lucas-traumen/CAN-cluster/hardware/board-stm32-v1/actuator-v1/actuator-v1.kicad_pcb

## KiCad design hardware/board-stm32-v1/actuator-v1/actuator-v1.kicad_pcb (2026-10-07)

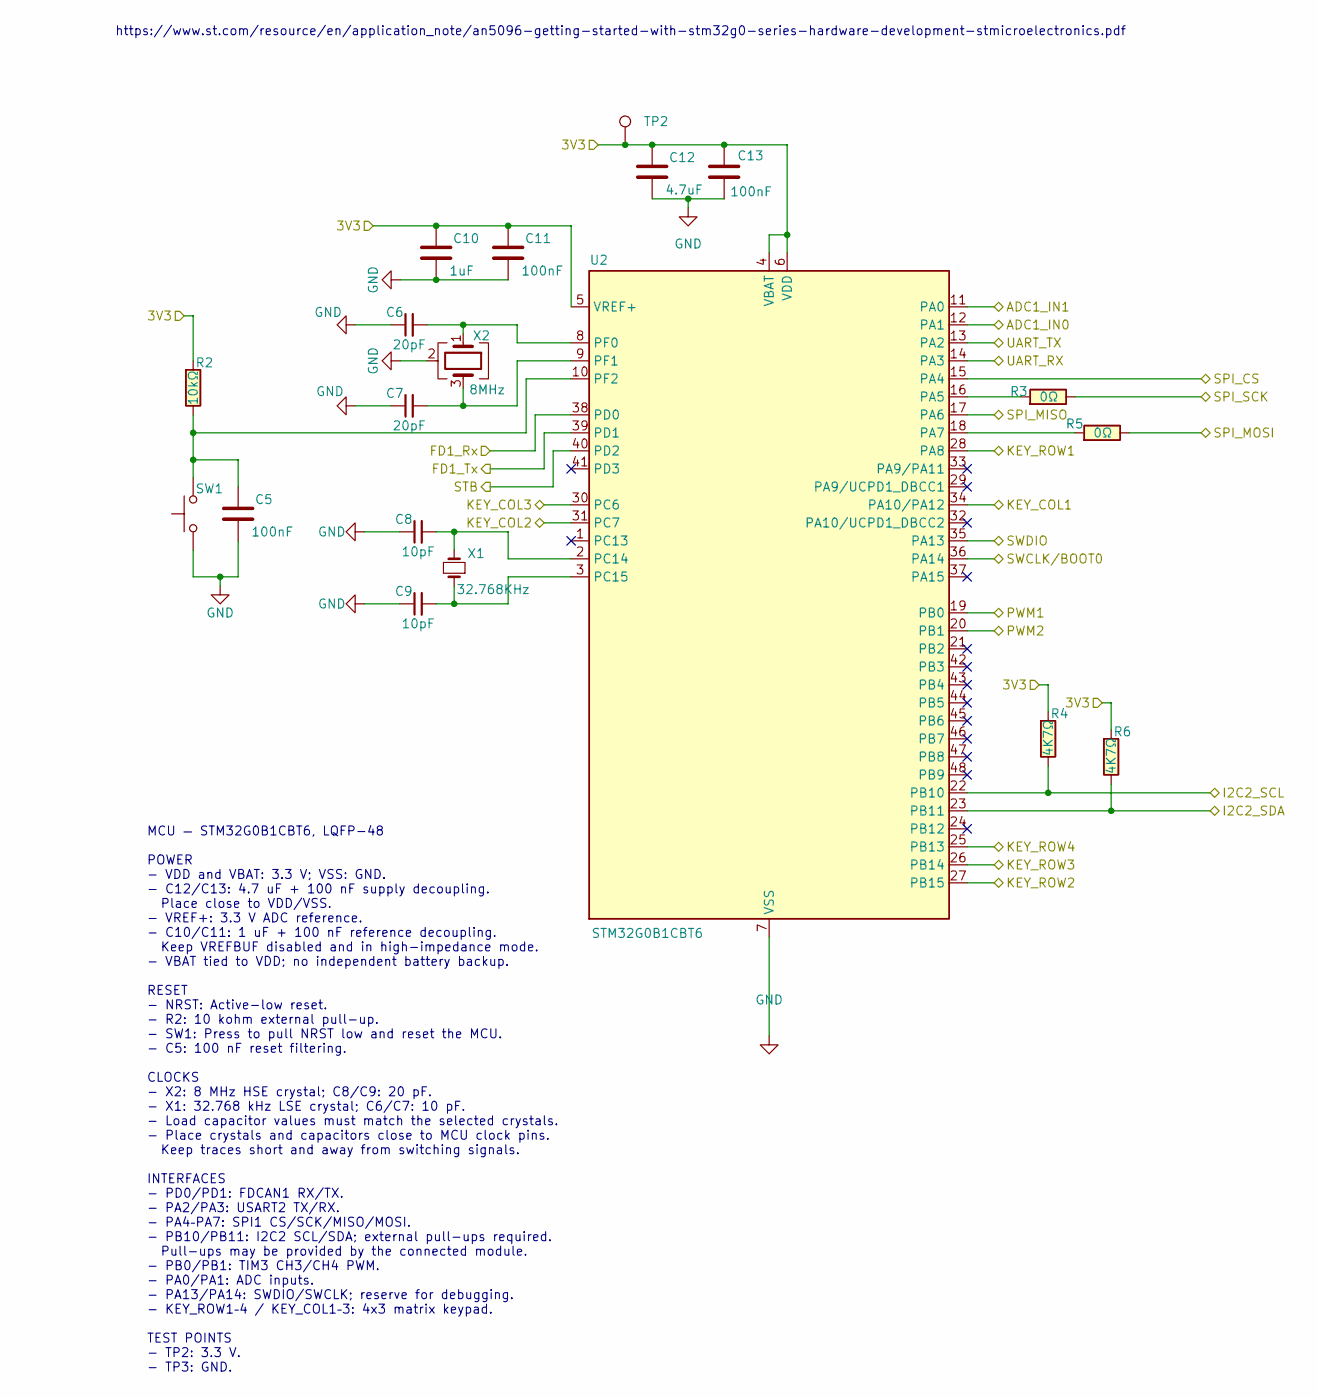
[picture p1: schematic MCU-STM32G0B1RBT6.kicad_sch]

Parts:
C5, C11, C13: 100nF; C_0603
C6, C7: 20pF; C_0603
C8, C9: 10pF; C_0603
C10: 1uF; C_0603
C12: 4.7uF; C_0603
R2: 10kΩ; R_0603
R3, R5: 0Ω; R_0603
R4, R6: 4K7Ω; R_0603
SW1: SW_Push; SW_SPST_CK_RS282G05A3
TP2: TestPoint; TestPoint_Pad_D1.5mm
U2: STM32G0B1CBT6; LQFP-48_7x7mm_P0.5mm
X1: 32.768KHz; Crystal_SMD_3215-2Pin_3.2x1.5mm
X2: 8MHz; Crystal_SMD_3225-4Pin_3.2x2.5mm

Connections:
/MCU-STM32G0B1CBT6/ADC1_IN0: U2.12 (PA1); also elsewhere on the board
/MCU-STM32G0B1CBT6/ADC1_IN1: U2.11 (PA0); also elsewhere on the board
/MCU-STM32G0B1CBT6/FD1_Rx: U2.38 (PD0); also elsewhere on the board
/MCU-STM32G0B1CBT6/FD1_Tx: U2.39 (PD1); also elsewhere on the board
/MCU-STM32G0B1CBT6/I2C2_SCL: R4.2, U2.22 (PB10); also elsewhere on the board
/MCU-STM32G0B1CBT6/I2C2_SDA: R6.2, U2.23 (PB11); also elsewhere on the board
/MCU-STM32G0B1CBT6/KEY_COL1: U2.34 (PA10/PA12); also elsewhere on the board
/MCU-STM32G0B1CBT6/KEY_COL2: U2.31 (PC7); also elsewhere on the board
/MCU-STM32G0B1CBT6/KEY_COL3: U2.30 (PC6); also elsewhere on the board
/MCU-STM32G0B1CBT6/KEY_ROW1: U2.28 (PA8); also elsewhere on the board
/MCU-STM32G0B1CBT6/KEY_ROW2: U2.27 (PB15); also elsewhere on the board
/MCU-STM32G0B1CBT6/KEY_ROW3: U2.26 (PB14); also elsewhere on the board
/MCU-STM32G0B1CBT6/KEY_ROW4: U2.25 (PB13); also elsewhere on the board
/MCU-STM32G0B1CBT6/PWM1: U2.19 (PB0); also elsewhere on the board
/MCU-STM32G0B1CBT6/PWM2: U2.20 (PB1); also elsewhere on the board
/MCU-STM32G0B1CBT6/SPI_CS: U2.15 (PA4); also elsewhere on the board
/MCU-STM32G0B1CBT6/SPI_MISO: U2.17 (PA6); also elsewhere on the board
/MCU-STM32G0B1CBT6/SPI_MOSI: R5.2; also elsewhere on the board
/MCU-STM32G0B1CBT6/SPI_SCK: R3.2; also elsewhere on the board
/MCU-STM32G0B1CBT6/STB: U2.40 (PD2); also elsewhere on the board
/MCU-STM32G0B1CBT6/SWCLK/BOOT0: U2.36 (PA14); also elsewhere on the board
/MCU-STM32G0B1CBT6/SWDIO: U2.35 (PA13); also elsewhere on the board
/MCU-STM32G0B1CBT6/UART_RX: U2.14 (PA3); also elsewhere on the board
/MCU-STM32G0B1CBT6/UART_TX: U2.13 (PA2); also elsewhere on the board
/Power5-3V3/+3V3: C10.1, C11.1, C12.1, C13.1, R2.1, R4.1, R6.1, TP2.1 (1_1), U2.4 (VBAT), U2.5 (VREF+), U2.6 (VDD); also elsewhere on the board
GND: C5.2, C6.1, C7.1, C8.1, C9.1, C10.2, C11.2, C12.2, C13.2, SW1.1, U2.7 (VSS), X2.2 (G), X2.4 (G); also elsewhere on the board
unnamed: R3.1, U2.16 (PA5)
unnamed: R5.1, U2.18 (PA7)
unnamed: C8.2, U2.2 (PC14), X1.2
unnamed: C9.2, U2.3 (PC15), X1.1
unnamed: C6.2, U2.8 (PF0), X2.1
unnamed: C7.2, U2.9 (PF1), X2.3
unnamed: C5.1, R2.2, SW1.2, U2.10 (PF2)

Notes on the sheet:
MCU — STM32G0B1CBT6, LQFP-48 POWER - VDD and VBAT: 3.3 V; VSS: GND. - C12/C13: 4.7 uF + 100 nF supply decoupling. Place close to VDD/VSS. - VREF+: 3.3 V ADC reference. - C10/C11: 1 uF + 100 nF reference decoupling. Keep VREFBUF disabled and in high-impedance mode. - VBAT tied to VDD; no independent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
https://www.st.com/resource/en/application_note/an5096-getting-started-with-stm32g0-series-hardware-development-stmicroelectronics.pdf

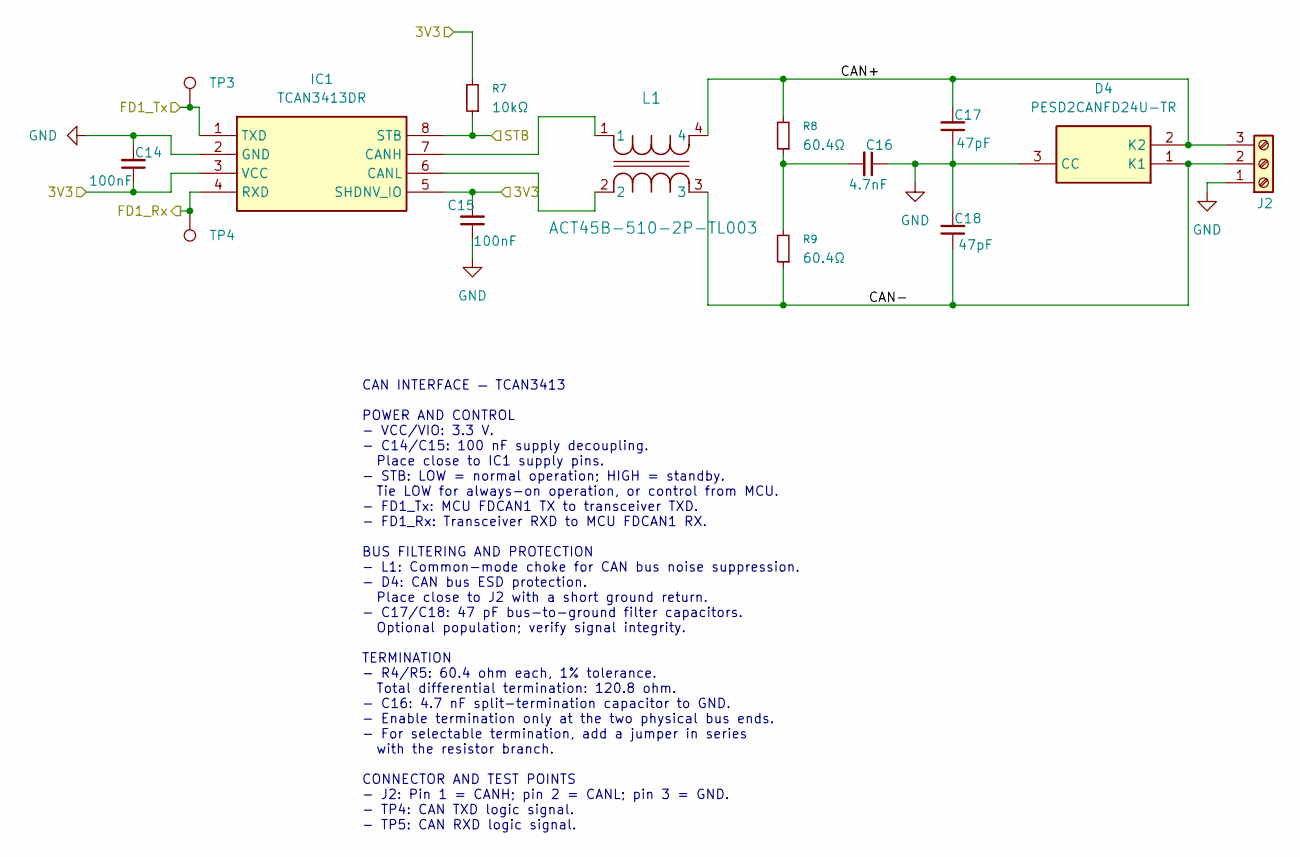
[picture p2: schematic TCAN3413.kicad_sch]

Parts:
C14, C15: 100nF; C_0603
C16: 4.7nF; C_0603
C17, C18: 47pF; C_0603
D4: PESD2CANFD24U-TR; SOT95P230X110-3N; Manufacturer_Part_Number PESD2CANFD24U-TR; Mouser Part Number 771-PESD2CANFD24U-TR
IC1: TCAN3413DR; SOIC127P600X175-8N; Manufacturer_Part_Number TCAN3413DR; Mouser Part Number 595-TCAN3413DR
J2: Screw_Terminal_01x03; PhoenixContact_MSTBA_2,5_3-G-5,08_1x03_P5.08mm_Horizontal
L1: ACT45B-510-2P-TL003; IND_ACT45R_TDK
R7: 10kΩ; R_0603
R8, R9: 60.4Ω; R_0805_2012Metric
TP3, TP4: TestPoint; TestPoint_Pad_D1.0mm

Connections:
/MCU-STM32G0B1CBT6/FD1_Rx: IC1.4 (RXD), TP4.1 (1_1); also elsewhere on the board
/MCU-STM32G0B1CBT6/FD1_Tx: IC1.1 (TXD), TP3.1 (1_1); also elsewhere on the board
/MCU-STM32G0B1CBT6/STB: IC1.8 (STB), R7.1; also elsewhere on the board
/Power5-3V3/+3V3: C14.1, C15.2, IC1.3 (VCC), IC1.5 (SHDNV_IO), R7.2; also elsewhere on the board
/TCAN3413/CAN+: C17.2, D4.2 (K2), J2.3, L1.4, R8.2
/TCAN3413/CAN-: C18.1, D4.1 (K1), J2.2, L1.3, R9.1
GND: C14.2, C15.1, C16.1, C17.1, C18.2, D4.3 (CC), IC1.2 (GND), J2.1; also elsewhere on the board
unnamed: C16.2, R8.1, R9.2
unnamed: IC1.7 (CANH), L1.1
unnamed: IC1.6 (CANL), L1.2

Notes on the sheet:
CAN INTERFACE — TCAN3413 POWER AND CONTROL - VCC/VIO: 3.3 V. - C14/C15: 100 nF supply decoupling. Place close to IC1 supply pins. - STB: LOW = normal operation; HIGH = standby. Tie LOW for always-on operation, or control from MCU. - FD1_Tx: MCU FDCAN1 TX to transceiver TXD. - FD1_Rx: Transceiver RX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

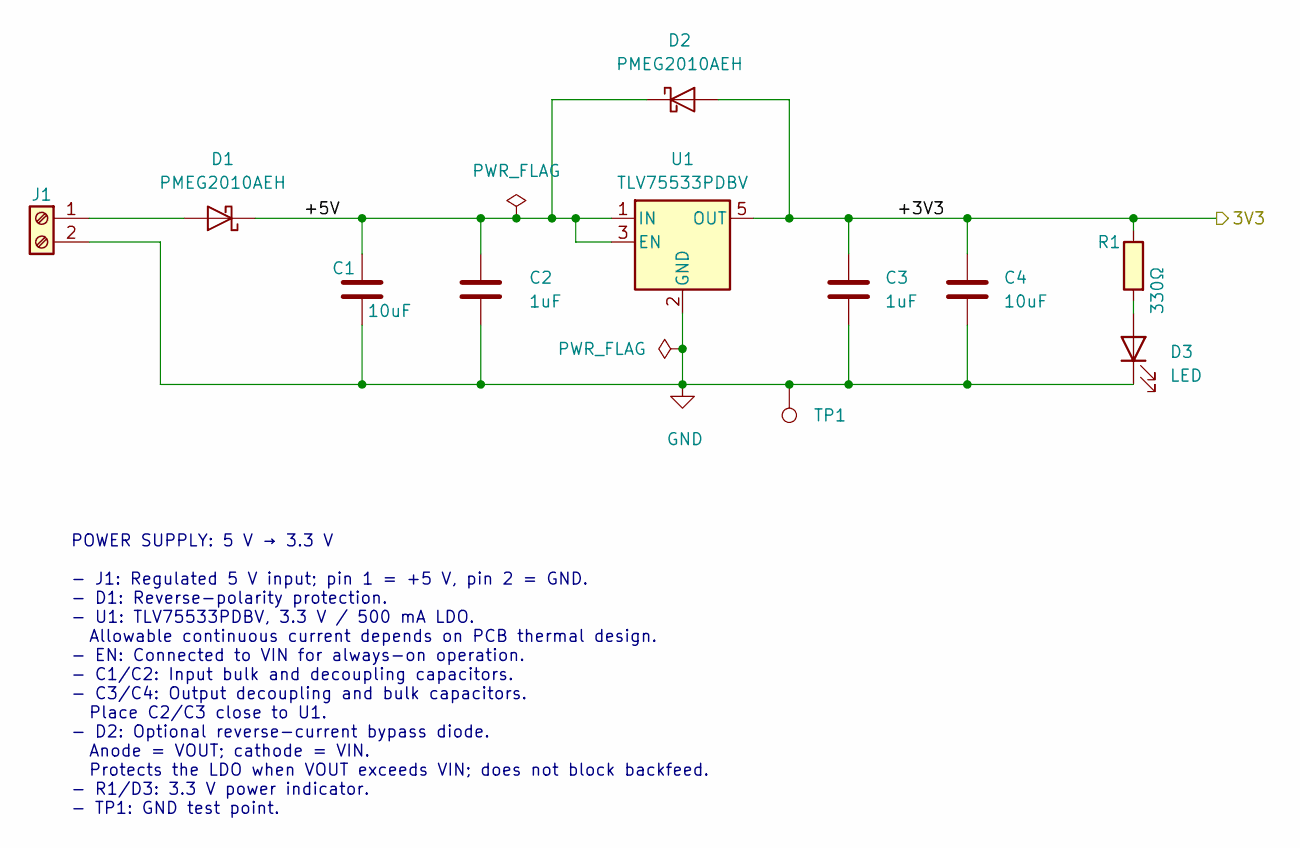
[picture p3: schematic Power5-3V3.kicad_sch]

Parts:
C1, C4: 10uF; C_0805_2012Metric_Pad1.18x1.45mm_HandSolder
C2, C3: 1uF; C_0603
D1, D2: PMEG2010AEH; D_SOD-123F
D3: LED; LED_0603_1608Metric
J1: Screw_Terminal_01x02; PhoenixContact_MSTBA_2,5_2-G-5,08_1x02_P5.08mm_Horizontal
R1: 330Ω; R_0603
TP1: TestPoint; TestPoint_Pad_D1.5mm
U1: TLV75533PDBV; SOT-23-5

Connections:
/Power5-3V3/+3V3: C3.1, C4.1, D2.2 (A), R1.2, U1.5 (OUT); also elsewhere on the board
/Power5-3V3/+5V: C1.1, C2.1, D1.1 (K), D2.1 (K), U1.1 (IN), U1.3 (EN)
GND: C1.2, C2.2, C3.2, C4.2, D3.1 (K), J1.2, TP1.1 (1_1), U1.2 (GND); also elsewhere on the board
unnamed: D1.2 (A), J1.1
unnamed: D3.2 (A), R1.1

Notes on the sheet:
POWER SUPPLY: 5 V → 3.3 V - J1: Regulated 5 V input; pin 1 = +5 V, pin 2 = GND. - D1: Reverse-polarity protection. - U1: TLV75533PDBV, 3.3 V / 500 mA LDO. Allowable continuous current depends on PCB thermal design. - EN: Connected to VIN for always-on operation. - C1/C2: Input bulk and decoupling c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

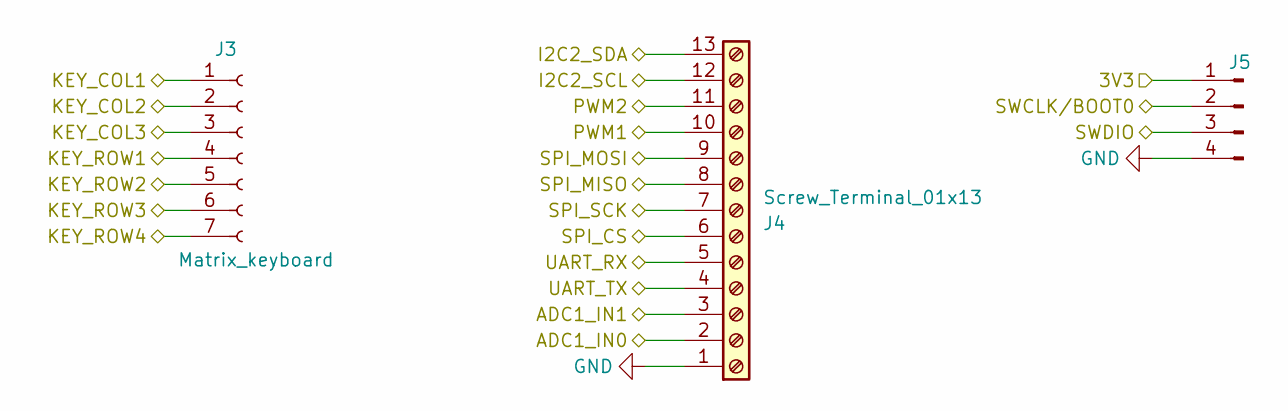
[picture p4: schematic Terminal.kicad_sch]

Parts:
J3: Matrix_keyboard; JST_XH_B7B-XH-A_1x07_P2.50mm_Vertical
J4: Screw_Terminal_01x13; PhoenixContact_MSTBA_2,5_13-G-5,08_1x13_P5.08mm_Horizontal
J5: Conn_01x04_Pin; PinHeader_1x04_P2.54mm_Vertical

Connections:
/MCU-STM32G0B1CBT6/ADC1_IN0: J4.2; also elsewhere on the board
/MCU-STM32G0B1CBT6/ADC1_IN1: J4.3; also elsewhere on the board
/MCU-STM32G0B1CBT6/I2C2_SCL: J4.12; also elsewhere on the board
/MCU-STM32G0B1CBT6/I2C2_SDA: J4.13; also elsewhere on the board
/MCU-STM32G0B1CBT6/KEY_COL1: J3.1; also elsewhere on the board
/MCU-STM32G0B1CBT6/KEY_COL2: J3.2; also elsewhere on the board
/MCU-STM32G0B1CBT6/KEY_COL3: J3.3; also elsewhere on the board
/MCU-STM32G0B1CBT6/KEY_ROW1: J3.4; also elsewhere on the board
/MCU-STM32G0B1CBT6/KEY_ROW2: J3.5; also elsewhere on the board
/MCU-STM32G0B1CBT6/KEY_ROW3: J3.6; also elsewhere on the board
/MCU-STM32G0B1CBT6/KEY_ROW4: J3.7; also elsewhere on the board
/MCU-STM32G0B1CBT6/PWM1: J4.10; also elsewhere on the board
/MCU-STM32G0B1CBT6/PWM2: J4.11; also elsewhere on the board
/MCU-STM32G0B1CBT6/SPI_CS: J4.6; also elsewhere on the board
/MCU-STM32G0B1CBT6/SPI_MISO: J4.8; also elsewhere on the board
/MCU-STM32G0B1CBT6/SPI_MOSI: J4.9; also elsewhere on the board
/MCU-STM32G0B1CBT6/SPI_SCK: J4.7; also elsewhere on the board
/MCU-STM32G0B1CBT6/SWCLK/BOOT0: J5.2; also elsewhere on the board
/MCU-STM32G0B1CBT6/SWDIO: J5.3; also elsewhere on the board
/MCU-STM32G0B1CBT6/UART_RX: J4.5; also elsewhere on the board
/MCU-STM32G0B1CBT6/UART_TX: J4.4; also elsewhere on the board
/Power5-3V3/+3V3: J5.1; also elsewhere on the board
GND: J4.1, J5.4; also elsewhere on the board

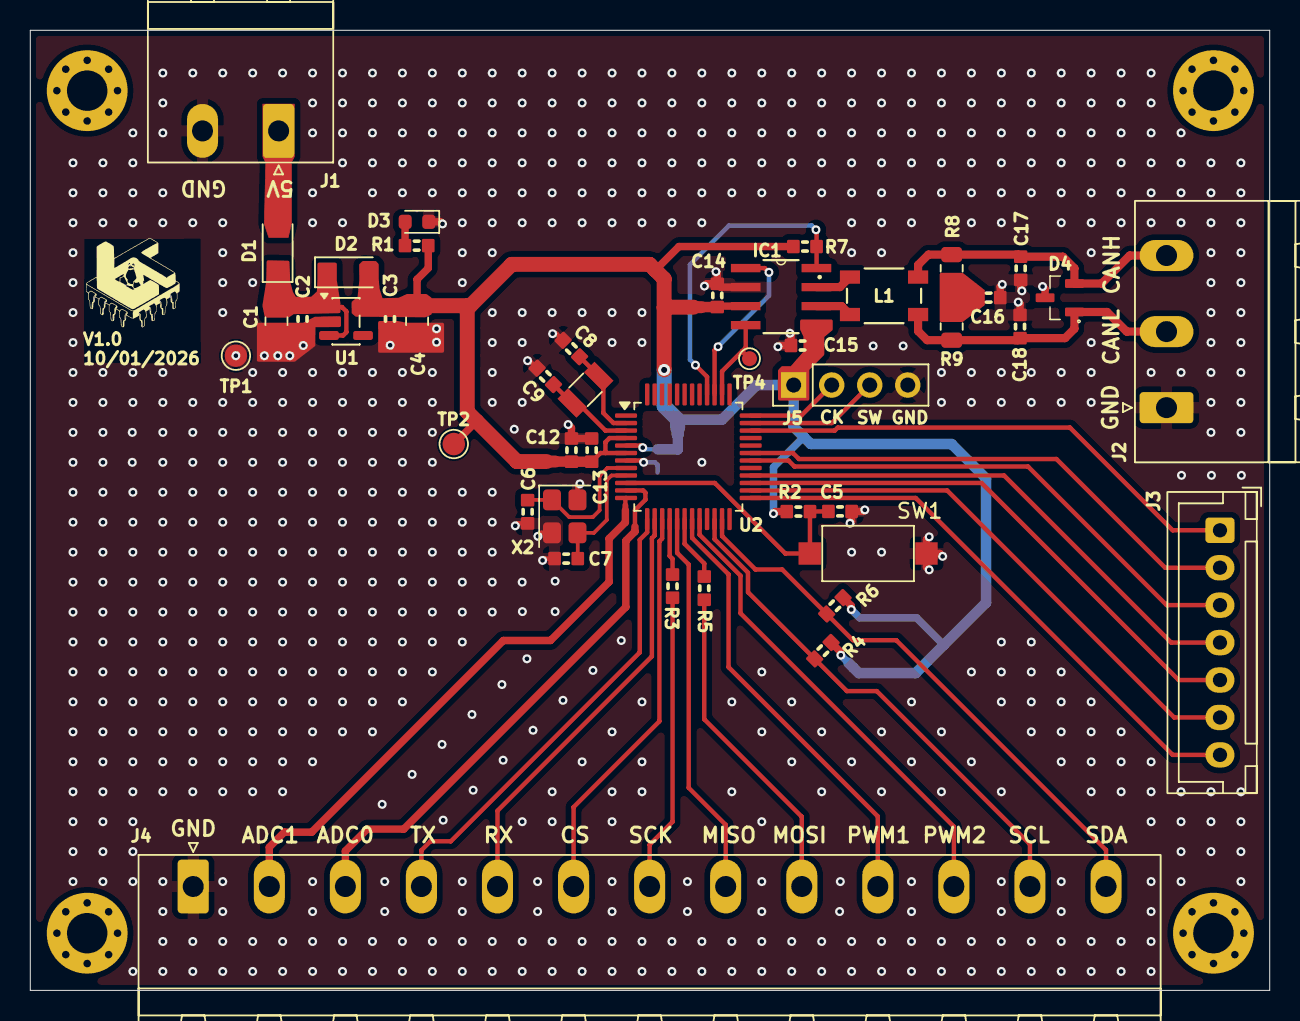
[picture p5: board actuator-v1.kicad_pcb from above]

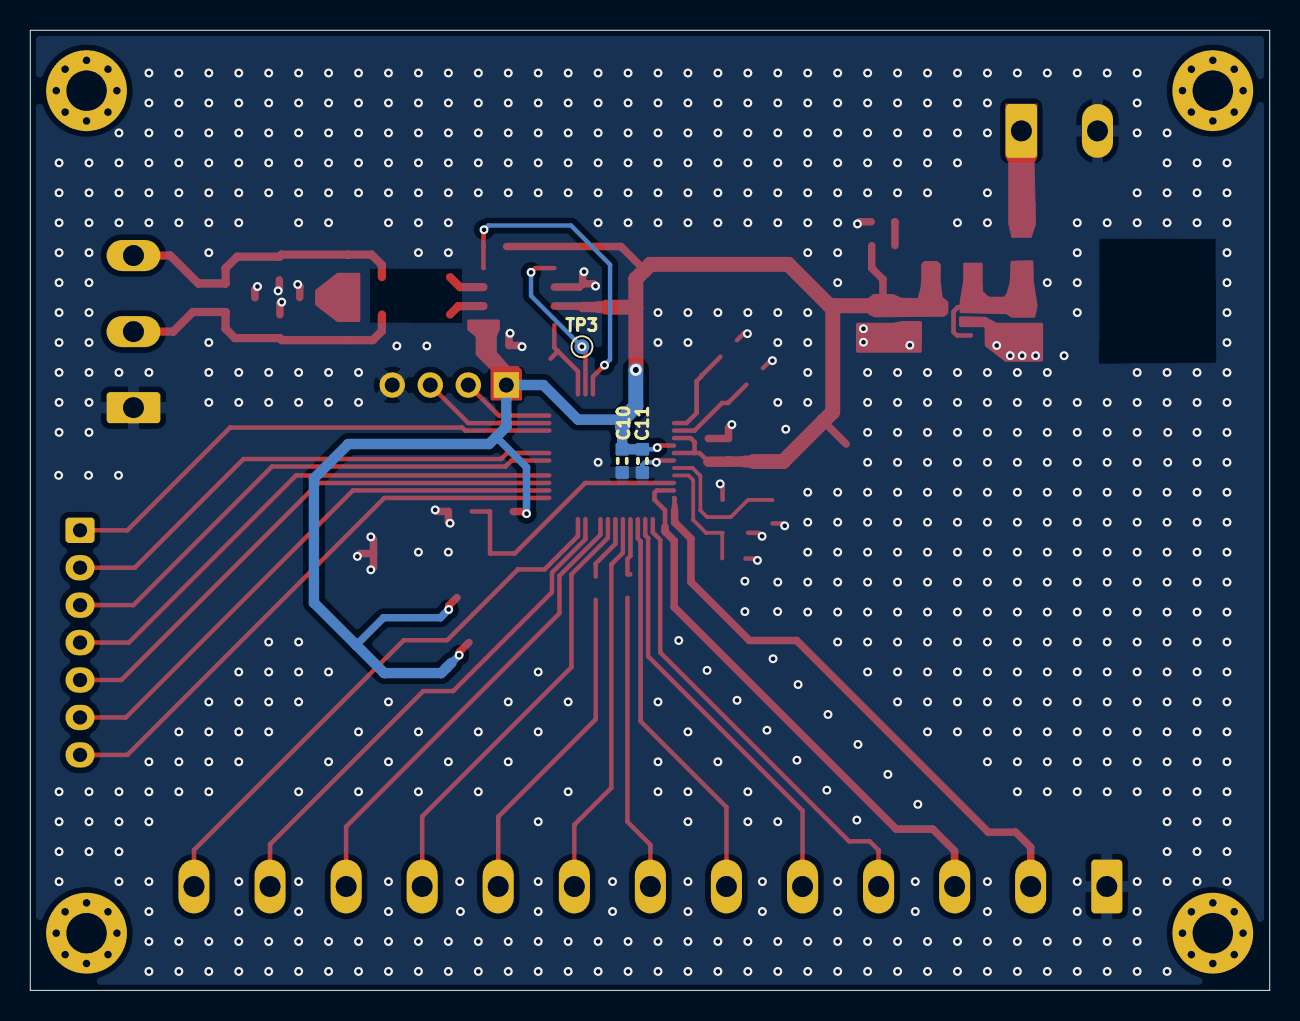
[picture p6: board actuator-v1.kicad_pcb from below]

Board: 2 copper layers, 82.8 x 64.1 mm, 47 parts (3 on the bottom side), 41 nets.
