lucas-traumen/CAN-cluster/(commit log)

2026-09-30 Initial commit: actuator-v1 STM32G0B1 CAN board
    [MCU-STM32G0B1RBT6.kicad_sch, Power5-3V3.kicad_sch, TCAN3413.kicad_sch, Terminal.kicad_sch, actuator-v1.kicad_pcb, actuator-v1.kicad_sch]
2026-10-07 Update actuator PCB layout and schematics
    [MCU-STM32G0B1RBT6.kicad_sch, TCAN3413.kicad_sch, actuator-v1.kicad_pcb]
2026-10-07 Update PCB output and manufacturing files
    [actuator-v1-B_Cu.gbr, actuator-v1-B_Mask.gbr, actuator-v1-B_Paste.gbr, actuator-v1-B_Silkscreen.gbr, actuator-v1-Edge_Cuts.gbr, actuator-v1-F_Cu.gbr, actuator-v1-F_Mask.gbr, actuator-v1-F_Paste.gbr]
